Radian0523/control-air-with-phone/README.md

# home-ir-remote（おうちリモコン）

iPhone から三菱電機エアコンと天井照明を操作する個人プロジェクト。
iPhone → Cloudflare Worker / Durable Object → WebSocket (TLS) → ESP32 → 赤外線 → エアコン。

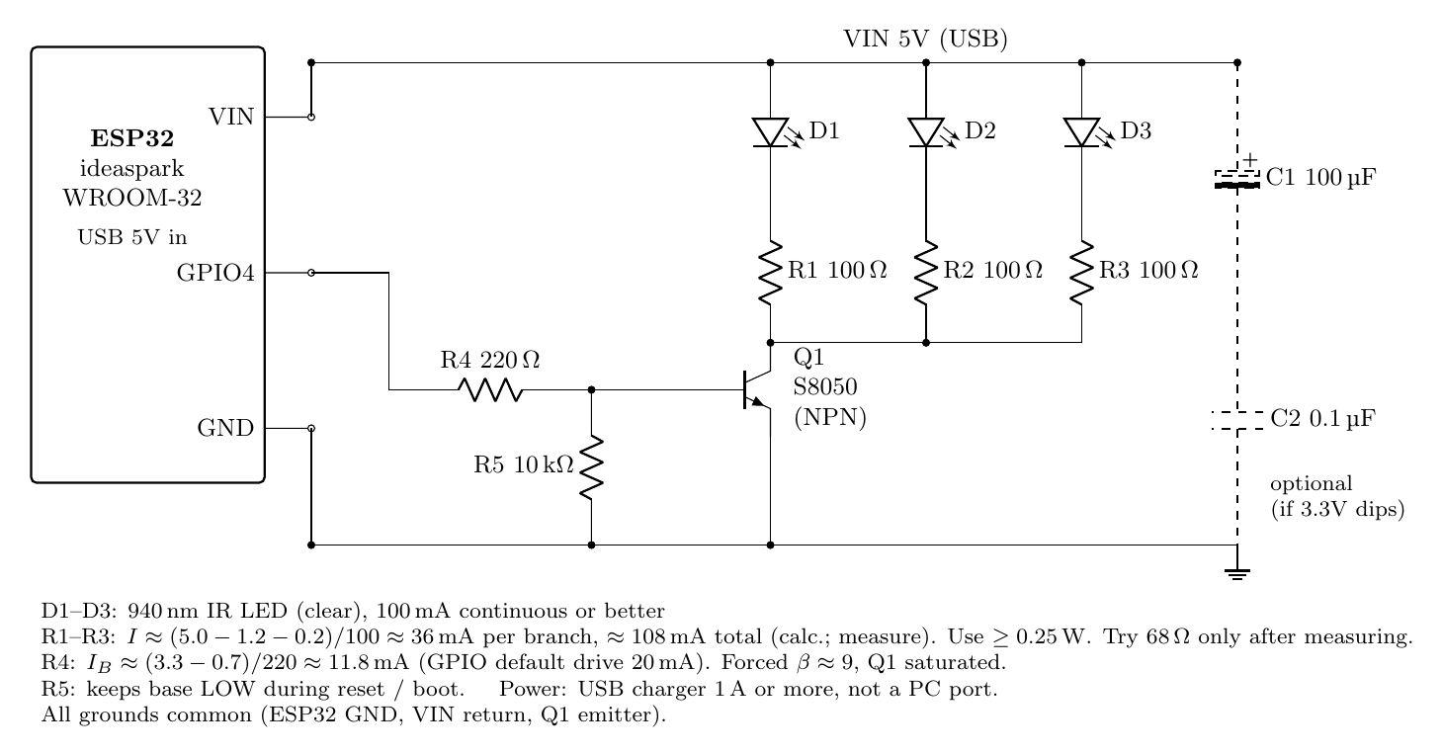
[picture p1: docs/circuit/ir_driver.png]
IR driver circuit


## 何ができるか

- iPhone アプリから電源・モード・温度・風量・風向を設定して即時送信
- 「この時刻にこの設定で」の一発予約 1 件（Durable Object の Alarm で発火）
- 照明（オーデリック）を全灯・ECO・常夜灯・消灯の 4 ボタンで操作（ADR-022）
- ESP32 は常時 WebSocket 接続。切断後は 30 秒周期で再接続し、10 分戻れなければ自動で再起動（ADR-021）
- 外出先からも同じ操作（LAN 直通経路は作らず、クラウド経由のみ。ADR-002）

## 構成

```
 iPhone (SwiftUI)
    │  HTTPS + Bearer(APP_TOKEN)
    ▼
 Cloudflare Worker ── 認証・API (/command, /light, /schedule)
    │  RPC
    ▼
 Durable Object "home" ── エアコンの 18 バイト / 照明の NEC コードを生成、予約 1 件を保持、Alarm
    │  WebSocket over TLS (Hibernation)、Bearer(DEVICE_TOKEN)
    ▼
 ESP32-WROOM-32 ── 36 文字（エアコン）/ 8 文字（照明）の HEX を受けて IRremoteESP8266 で送信するだけ
    │  GPIO4 → S8050 → IR LED ×3 (940nm)
    ▼
 三菱電機 エアコン (MITSUBISHI_AC, 144 bit) / オーデリック 照明 (NEC, 32 bit)
```

設計の要点は「ESP32 を最小にし、判断はすべてクラウドに置く」（ADR-001, 008）。
機器プロトコルは片方向で、Durable Object → ESP32 に 36 文字（エアコン）か 8 文字（照明）の大文字 HEX を 1 フレーム送るだけ（ADR-010, 022）。ESP32 は返答せず、不正入力は黙って捨てる。

## 技術スタック

| 層 | 主な技術 |
|---|---|
| iOS | SwiftUI, Keychain（トークン保管）, XCTest, xcodegen |
| クラウド | Cloudflare Workers, Durable Objects (SQLite, WebSocket Hibernation, Alarm), TypeScript, wrangler, vitest + `@cloudflare/vitest-pool-workers` |
| ファーム | arduino-esp32 3.3.11, IRremoteESP8266, arduinoWebSockets, Mozilla CA bundle (`gen_crt_bundle.py`) |
| ハード | ESP32-WROOM-32, S8050 + 100Ω ×3 で IR LED 駆動（約 36 mA/個）, 回路図は CircuiTikZ |
| ドキュメント | 設計書, ADR ×22, レビュー記録, 試験記録, 振り返り |

テスト: Cloudflare 57 件（純粋関数 + workerd 上の統合）, iOS 15 件, ファームは host 側で `ir_frame.h` の単体テスト。

## リポジトリ構成

| 場所 | 内容 |
|---|---|
| [`cloudflare/`](cloudflare/) | Worker と Durable Object。`encoder.ts` が三菱フレーム生成の中心 |
| [`firmware/aircon_bridge/`](firmware/aircon_bridge/) | 本番ファーム（状態機械、TLS、Task WDT） |
| [`firmware/ir_serial_test/`](firmware/ir_serial_test/) | Wi-Fi なしでシリアルから赤外線を出す試験スケッチ |
| [`ios/AirconRemote/`](ios/AirconRemote/) | SwiftUI アプリ（設定・操作・予約） |
| [`tools/`](tools/) | 赤外線の採取・解析、照明の送信試験、回路電圧の測定、Wi-Fi スキャン用スケッチ |
| [`docs/`](docs/) | 下記 |

## ドキュメント

| 文書 | 内容 |
|---|---|
| [docs/design.md](docs/design.md) | 現行仕様（API、機器プロトコル、フレーム規則、ログ、障害判断表） |
| [docs/adr.md](docs/adr.md) | 設計判断 ADR-001〜022。なぜその構成にしたか |
| [docs/review-2026-09-13.md](docs/review-2026-09-13.md) | 実装前の設計レビュー 2 往復（17 件） |
| [docs/implementation-plan.md](docs/implementation-plan.md) | 8 段階の実装計画と通過条件、進行表 |
| [docs/ir-captures.md](docs/ir-captures.md) | 実機リモコンの赤外線採取と規則の導出 |
| [docs/test-log.md](docs/test-log.md) | 各段階の試験記録とつまずき一覧 |
| [docs/dev-retrospective.md](docs/dev-retrospective.md) | 開発の振り返り。つまずき・原因・解決 |
| [docs/stage5-procedure.md](docs/stage5-procedure.md) | 障害系試験の手順（診断用） |
| [docs/circuit/](docs/circuit/) | 赤外線送信回路図（`.tex` / `.pdf` / `.png`） |

## 自分で動かす

各ディレクトリの README を参照。おおまかには

1. `cloudflare/`: `npm install` → `npx wrangler secret put DEVICE_TOKEN` / `APP_TOKEN` → `npm run deploy`
2. `firmware/aircon_bridge/`: `secrets.example.h` を `secrets.h` にコピーして SSID・パスワード・ホスト・トークンを記入（2.4GHz のみ）→ Arduino IDE で書き込み
3. `ios/AirconRemote/`: `xcodegen generate` → Xcode で実行 → 設定画面に Worker の URL と APP_TOKEN を入力

`secrets.h` と Worker のシークレットはご自身の環境に合わせてください。
