Radian0523/control-air-with-phone/docs/ir-captures.md

# 実機リモコン採取記録

対象: 三菱電機エアコン（`MITSUBISHI_AC`、144 bit / 18 byte）  
採取手段: `tools/ir_dump`（受信モジュール Y → GPIO15、R → 3.3V、G → GND。解析時だけ接続）  
照合手段: `cd cloudflare && node scripts/decode.ts <36文字> [--expect power,mode,temp,fan,vane]`

段階2a のゲート（実装計画）:

- 静音の fan値が規則の5と一致する → リモコンに静音が存在しないため列挙から削除（ADR-019）
- 暖房 20℃ / 風量4 / 風向low が §7.2 の4件目と一致する → 風量4も存在しない。暖房・風向lowest の採取値でベクトルを差し替え
- 電源ONとOFFを含む複数設定で byte 10〜16 が `00 00 00 00 00 10 00` に固定できる → byte 10〜14 と 16 は常に `00`。byte 15 は `10` / `00` の両方が現れ、`10` 固定を維持

## 採取表（2026-09-13 第1回）

受信環境: 受信モジュール → GPIO15、`tools/ir_dump`（許容誤差 35%、ノイズ閾値 50 bit）。UNKNOWN が混ざるが、成功フレームが十分に取れた。
リモコンの風量ボタンの巡回は 1 → 2 → 3 → 自動 の4段で、風量4と静音は確認されなかった。

byte 0〜4 は全採取で `23 CB 26 01 00`、byte 10〜14 と byte 16 は全採取で `00`。以下は byte 5〜9、15、17 だけを記す。

| 操作 | byte 5 power | 6 mode | 7 temp | 8 | 9 | 15 | 17 sum | decode 結果 | encoder と一致 |
|---|---|---|---|---|---|---|---|---|---|
| 電源OFF（電源ボタン） | 00 | 18 | 0A | 36 | 58 | **10** | D5 | OFF cool 26 fan0 vane3 | 一致 |
| 電源ON（電源ボタン） | 20 | 18 | 0A | 36 | 58 | **10** | F5 | ON cool 26 fan0 vane3 | 一致 |
| 温度など別ボタン後 | 20 | 18 | 0A | 36 | 58 | **00** | E5 | ON cool 26 fan0 vane3 | byte 15 のみ不一致 |
| 温度 25℃ | 20 | 18 | 09 | 36 | 58 | 00 | E4 | temp 25 | byte 15 のみ不一致 |
| 風量ボタン 1回目 | 20 | 18 | 0A | 36 | 59 | 00 | E6 | fan 1 | byte 15 のみ不一致 |
| 風量ボタン 2回目 | 20 | 18 | 0A | 36 | 5A | 00 | E7 | fan 2 | byte 15 のみ不一致 |
| 風量ボタン 3回目 | 20 | 18 | 0A | 36 | 5B | 00 | E8 | fan 3 | byte 15 のみ不一致 |
| 風量ボタン 4回目（自動） | 20 | 18 | 0A | 36 | **98** | 00 | 25 | fan 0、bit7=1、bit6=0 | **byte 9 不一致** |
| 風向 low | 20 | 18 | 0A | 36 | 61 | 00 | EE | fan1 vane4 | byte 15 のみ不一致 |
| 風向 lowest | 20 | 18 | 0A | 36 | 69 | 00 | F6 | fan1 vane5 | byte 15 のみ不一致 |
| 風向 swing | 20 | 18 | 0A | 36 | 79 | 00 | 06 | fan1 vane7 | byte 15 のみ不一致 |
| 風向 auto | 20 | 18 | 0A | 36 | **81** | 00 | 0E | fan1 vane0、bit7=1、bit6=0 | **byte 9 不一致** |
| 風向 highest | 20 | 18 | 0A | 36 | 49 | 00 | D6 | fan1 vane1 | byte 15 のみ不一致 |
| 風向 high | 20 | 18 | 0A | 36 | 51 | 00 | DE | fan1 vane2 | byte 15 のみ不一致 |
| 風向 middle | 20 | 18 | 0A | 36 | 59 | 00 | E6 | fan1 vane3 | byte 15 のみ不一致 |
| モード dry（24℃） | 20 | 10 | 08 | 32 | 69 | 00 | E8 | dry | byte 15 のみ不一致 |
| モード heat（26℃） | 20 | 08 | 0A | 30 | 69 | 00 | E0 | heat | byte 15 のみ不一致 |
| 電源ボタン（再度） | 20 | 18 | 0A | 36 | 69 | **10** | 06 | ON cool 26 fan1 vane5 | 一致 |

### 規則との照合結果

一致が確認できた規則:

- byte 5 power、byte 6 と 8 の mode（cool 18/36、dry 10/32、heat 08/30）、byte 7 = temp − 16
- byte 9 の vane値 1〜5 と 7、fan値 1〜3。bit 6 = 1、bit 7 = 0 の形（規則どおり）
- byte 10〜14、byte 16 は常に 00
- byte 17 のチェックサム

規則と異なる観察:

1. **byte 15 は電源ボタンのフレームだけ `10`、他のボタンでは `00`**。byte 5 の power とは独立で、OFF フレームでも `10` だった。規則の固定値 `10` は電源ボタン相当の値であり、AC は両方を受理している。→ 規則は変更しない。段階2c で `10` 固定の非電源操作（温度変更など）に AC が反応することを確認する。
2. **byte 9 の上位2bit**。風量ボタンで「自動」を選んだフレームは `98`（bit7=1、bit6=0）、風向ボタンで「自動」を選んだフレームは `81`（bit7=1、bit6=0）。一方、電源ボタンのフレームでは fan auto が `58`（bit7=0、bit6=1）で表現されていた。規則（常に `40 | vane<<3 | fan`）は電源ボタン形式にだけ一致する。vane auto を規則で生成すると `41` になるが、この形は採取されていない。→ 追加採取で「フル状態」フレームでの表現を確定する（下記）。
3. **風量4と静音はこのリモコンにない**（巡回は 1→2→3→自動）。→ 設計§5.4 の fan 列挙から `quiet` と `4` を外す候補。

## 採取表（2026-09-16 第2回: 追加採取）

| 操作 | byte 5 | 6 | 7 | 8 | 9 | 15 | 17 | decode 結果 | encoder と一致 |
|---|---|---|---|---|---|---|---|---|---|
| 風向 auto にしてから電源ON | 20 | 18 | 0A | 36 | **41** | 10 | DE | ON cool 26 fan1 vane0 | **完全一致** |
| 風量 auto にしてから電源操作 | 20 | 18 | 0A | 36 | **40** | 00 | CD | ON cool 26 fan0 vane0 | byte 15 のみ不一致 |
| リセットボタン後に電源ON | 20 | 18 | 05 | 36 | **40** | 00 | C8 | ON cool 26→21℃ fan0 vane0 | byte 15 のみ不一致 |

リモコンの仕様（所有者確認）: 風量は 1 / 2 / 3 / 自動。モードに自動と送風はない。時刻設定はない。静音はなく、「パワフル」ボタンがある。

### 結論（2026-09-16）

- **byte 9 の規則 `40 | vane<<3 | fan`（bit 6=1、bit 7=0）はフルステートフレームで確定**。風向自動は `41`、風量・風向とも自動は `40`。第1回で見えた `98` / `81` はボタン操作直後だけの一時的な表現で、encoder は採用しない
- **byte 15 は `10` 固定を維持**。電源ボタンでは `10`、他のボタンやリセット後は `00` になるが、エアコンは両方を受理する
- **風量の `quiet` と `4` を列挙から外す**（ADR-019）。mode の `auto` と `fan` は採取できないため IRremoteESP8266 の値を保持する
- design.md §7.2 のテストベクトルを採取値ベースの5件へ差し替えた
- 段階2a のゲートは通過。パワフルは現在の要件外とし、必要になれば採取して追加する

### 第1回時点で追加採取が必要だった項目（第2回で解消）

電源ボタンのフレームは、リモコンが保持する全状態を載せるので、encoder が作るべき「フル状態」の正解になる。

- 風向ボタンで「自動」にした後、電源 OFF → ON を押し、両フレームの byte 9 を見る（vane auto のフル状態表現）
- 風量ボタンで「自動」にした後、電源 OFF → ON を押し、両フレームの byte 9 を見る（fan auto のフル状態表現が `58` 系か `98` 系か）
- モード「自動」と「送風」があれば、それぞれ選んだ後に電源 OFF → ON（byte 6 / 8 の auto=20/30、fan=38/37 の確認）
- リモコンの風量表示の段数（自動を除いて3段か）と、「静音」「パワフル」などの別ボタンの有無

## byte 10〜16 の観察

採取した全レコードの byte 10〜16 を並べる。ゼロでない値があれば、時計・タイマー由来かをリモコンの時刻設定を変えて再採取して切り分ける。

| 採取 | byte 10 | 11 | 12 | 13 | 14 | 15 | 16 |
|---|---|---|---|---|---|---|---|
| 既存（dry 24℃） | 00 | 00 | 00 | 00 | 00 | 10 | 00 |
| 第1回 電源ボタン（3件） | 00 | 00 | 00 | 00 | 00 | 10 | 00 |
| 第1回 その他ボタン（15件） | 00 | 00 | 00 | 00 | 00 | 00 | 00 |

時計・タイマー由来の値は出ていない。このリモコンには時刻設定がないため、byte 10〜14 は常に `00` と確定する。

## 結論

（採取後に記入。規則を変更した場合は design.md §7.1、encoder.ts、ADR-008 の結果へ追記し、ここにリンクを残す）

## 照明リモコン採取（2026-11-03）

対象: オーデリック リモコン送信機 NRL-3321。チャンネル設定は採取時のまま変更していない。
採取: `tools/ir_dump`（受信モジュール Y → GPIO15）、各ボタンを1回ずつ短押し。

| ボタン | プロトコル | ビット数 | コード | アドレス（16bit） | コマンド / 反転 |
|---|---|---|---|---|---|
| ECO | NEC | 32 | `0x01A3748B` | `0x01A3` | `0x74` / `0x8B` |
| ON | NEC | 32 | `0x01A359A6` | `0x01A3` | `0x59` / `0xA6` |
| 豆電 | NEC | 32 | `0x01A354AB` | `0x01A3` | `0x54` / `0xAB` |
| OFF | NEC | 32 | `0x01A310EF` | `0x01A3` | `0x10` / `0xEF` |

- 4件とも同じアドレス `0x01A3`（拡張 NEC。2バイト目は1バイト目の反転ではない）で、コマンドは反転バイトと XOR して `0xFF` になる
- エアコンのような状態フレームではなく、ボタンごとの固定コード
- 送信試験（2026-11-03）: `tools/ir_light_send_test` から本番と同じ GPIO4 の LED 回路で `IRsend::sendNEC(code, 32)` を1回ずつ送り、OFF → ON → 豆電 → ECO → ON の5回すべてに照明が反応した。再送や繰り返しは不要
