Radian0523/control-air-with-phone/docs/circuit/ir_driver.pdf

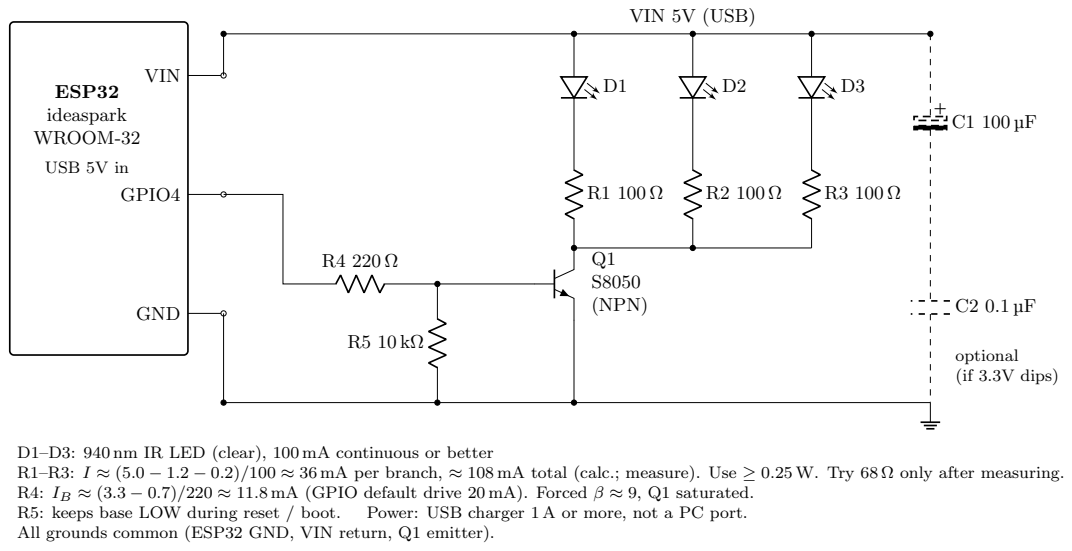
[picture p2: page 1]

D1–D3: 940 nm IR LED (clear), 100 mA continuous or better
R1–R3: I ≈ (5.0 − 1.2 − 0.2)/100 ≈ 36 mA per branch, ≈ 108 mA total (calc.; measure). Use ≥ 0.25W. Try 68 Ω only after measuring.
R4: IB ≈ (3.3 − 0.7)/220 ≈ 11.8 mA (GPIO default drive 20 mA). Forced β ≈ 9, Q1 saturated.
All grounds common (ESP32 GND, VIN return, Q1 emitter).
