Radian0523/control-air-with-phone/firmware/aircon_bridge/ca_bundle.h

const unsigned char ca_bundle[] = {
  0x00, 0x79, 0x00, 0x3a, 0x02, 0x26, 0x30, 0x38, 0x31, 0x0b, 0x30, 0x09,
  0x06, 0x03, 0x55, 0x04, 0x06, 0x13, 0x02, 0x45, 0x53, 0x31, 0x14, 0x30,
  0x12, 0x06, 0x03, 0x55, 0x04, 0x0a, 0x0c, 0x0b, 0x49, 0x5a, 0x45, 0x4e,
  0x50, 0x45, 0x20, 0x53, 0x2e, 0x41, 0x2e, 0x31, 0x13, 0x30, 0x11, 0x06,
  0x03, 0x55, 0x04, 0x03, 0x0c, 0x0a, 0x49, 0x7a, 0x65, 0x6e, 0x70, 0x65,
  0x2e, 0x63, 0x6f, 0x6d, 0x30, 0x82, 0x02, 0x22, 0x30, 0x0d, 0x06, 0x09,
  0x2a, 0x86, 0x48, 0x86, 0xf7, 0x0d, 0x01, 0x01, 0x01, 0x05, 0x00, 0x03,
  0x82, 0x02, 0x0f, 0x00, 0x30, 0x82, 0x02, 0x0a, 0x02, 0x82, 0x02, 0x01,
  0x00, 0xc9, 0xd3, 0x7a, 0xca, 0x0f, 0x1e, 0xac, 0xa7, 0x86, 0xe8, 0x16,
  0x65, 0x6a, 0xb1, 0xc2, 0x1b, 0x45, 0x32, 0x71, 0x95, 0xd9, 0xfe, 0x10,
  0x5b, 0xcc, 0xaf, 0xe7, 0xa5, 0x79, 0x01, 0x8f, 0x89, 0xc3, 0xca, 0xf2,
  0x55, 0x71, 0xf7, 0x77, 0xbe, 0x77, 0x94, 0xf3, 0x72, 0xa4, 0x2c, 0x44,
  0xd8, 0x9e, 0x92, 0x9b, 0x14, 0x3a, 0xa1, 0xe7, 0x24, 0x90, 0x0a, 0x0a,
  0x56, 0x8e, 0xc5, 0xd8, 0x26, 0x94, 0xe1, 0xd9, 0x48, 0xe1, 0x2d, 0x3e,
  0xda, 0x0a, 0x72, 0xdd, 0xa3, 0x99, 0x15, 0xda, 0x81, 0xa2, 0x87, 0xf4,
  0x7b, 0x6e, 0x26, 0x77, 0x89, 0x58, 0xad, 0xd6, 0xeb, 0x0c, 0xb2, 0x41,
  0x7a, 0x73, 0x6e, 0x6d, 0xdb, 0x7a, 0x78, 0x41, 0xe9, 0x08, 0x88, 0x12,
  0x7e, 0x87, 0x2e, 0x66, 0x11, 0x63, 0x6c, 0x54, 0xfb, 0x3c, 0x9d, 0x72,
  0xc0, 0xbc, 0x2e, 0xff, 0xc2, 0xb7, 0xdd, 0x0d, 0x76, 0xe3, 0x3a, 0xd7,
  0xf7, 0xb4, 0x68, 0xbe, 0xa2, 0xf5, 0xe3, 0x81, 0x6e, 0xc1, 0x46, 0x6f,
  0x5d, 0x8d, 0xe0, 0x4d, 0xc6, 0x54, 0x55, 0x89, 0x1a, 0x33, 0x31, 0x0a,
  0xb1, 0x57, 0xb9, 0xa3, 0x8a, 0x98, 0xc3, 0xec, 0x3b, 0x34, 0xc5, 0x95,
  0x41, 0x69, 0x7e, 0x75, 0xc2, 0x3c, 0x20, 0xc5, 0x61, 0xba, 0x51, 0x47,
  0xa0, 0x20, 0x90, 0x93, 0xa1, 0x90, 0x4b, 0xf3, 0x4e, 0x7c, 0x85, 0x45,
  0x54, 0x9a, 0xd1, 0x05, 0x26, 0x41, 0xb0, 0xb5, 0x4d, 0x1d, 0x33, 0xbe,
  0xc4, 0x03, 0xc8, 0x25, 0x7c, 0xc1, 0x70, 0xdb, 0x3b, 0xf4, 0x09, 0x2d,
  0x54, 0x27, 0x48, 0xac, 0x2f, 0xe1, 0xc4, 0xac, 0x3e, 0xc8, 0xcb, 0x92,
  0x4c, 0x53, 0x39, 0x37, 0x23, 0xec, 0xd3, 0x01, 0xf9, 0xe0, 0x09, 0x44,
  0x4d, 0x4d, 0x64, 0xc0, 0xe1, 0x0d, 0x5a, 0x87, 0x22, 0xbc, 0xad, 0x1b,
  0xa3, 0xfe, 0x26, 0xb5, 0x15, 0xf3, 0xa7, 0xfc, 0x84, 0x19, 0xe9, 0xec,
  0xa1, 0x88, 0xb4, 0x44, 0x69, 0x84, 0x83, 0xf3, 0x89, 0xd1, 0x74, 0x06,
  0xa9, 0xcc, 0x0b, 0xd6, 0xc2, 0xde, 0x27, 0x85, 0x50, 0x26, 0xca, 0x17,
  0xb8, 0xc9, 0x7a, 0x87, 0x56, 0x2c, 0x1a, 0x01, 0x1e, 0x6c, 0xbe, 0x13,
  0xad, 0x10, 0xac, 0xb5, 0x24, 0xf5, 0x38, 0x91, 0xa1, 0xd6, 0x4b, 0xda,
  0xf1, 0xbb, 0xd2, 0xde, 0x47, 0xb5, 0xf1, 0xbc, 0x81, 0xf6, 0x59, 0x6b,
  0xcf, 0x19, 0x53, 0xe9, 0x8d, 0x15, 0xcb, 0x4a, 0xcb, 0xa9, 0x6f, 0x44,
  0xe5, 0x1b, 0x41, 0xcf, 0xe1, 0x86, 0xa7, 0xca, 0xd0, 0x6a, 0x9f, 0xbc,
  0x4c, 0x8d, 0x06, 0x33, 0x5a, 0xa2, 0x85, 0xe5, 0x90, 0x35, 0xa0, 0x62,
  0x5c, 0x16, 0x4e, 0xf0, 0xe3, 0xa2, 0xfa, 0x03, 0x1a, 0xb4, 0x2c, 0x71,
  0xb3, 0x58, 0x2c, 0xde, 0x7b, 0x0b, 0xdb, 0x1a, 0x0f, 0xeb, 0xde, 0x21,
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
};
const unsigned int ca_bundle_len = 55587;
