Radian0523/control-air-with-phone/(commit log)

2026-09-13 chore: リポジトリ準備（段階0）
    - 設計・ADR・レビュー・実装計画・回路図
    - 赤外線解析スケッチ（tools/）
    - cloudflare/ firmware/ ios/ の骨格と README
    - secrets.example.h と CA bundle 記録の雛形
    - wrangler / vitest / vitest-pool-workers を devDependency に固定
2026-09-13 feat(cloudflare): Encoder と検証の純粋関数（段階1）
    - encoder.ts: design.md §7.1 の18バイト生成と36文字化
    - validate.ts: §5.4 設定検証、§5.2 executeAt 検証（現在時刻は引数）
    - test: §7.2 の4ベクトル（採取/導出を明記）、形式の不変条件、境界値
    - tsconfig / vitest.config（段階1は Node 環境）
2026-09-13 feat(firmware): シリアル試験スケッチと採取準備（段階2c）
    - firmware/ir_serial_test: USBシリアルから36文字を受けて MITSUBISHI_AC 送信
    - ir_frame.h: §4.3 の検証と18バイト変換。本番ファームと共用する
    - host_test: 不正入力の拒否をホスト側で検査
    - docs/ir-captures.md: 段階2a の採取記録テンプレート
    - cloudflare/scripts/decode.ts: 採取36文字の分解と encoder との照合
2026-09-13 fix(tools): ir_dump が UNKNOWN 時に生タイミングを出力し、許容誤差とノイズ閾値を調整
    [ir_dump.ino]
2026-09-13 docs: 実機リモコン採取 第1回の記録と規則との照合結果
2026-09-16 feat(cloudflare): 採取結果を設計・ADR・encoder へ反映（段階2a 完了）
    - byte 9 の規則をフルステートフレームで確定、byte 15 は 10 固定を維持
    - 風量の列挙を auto/1/2/3 へ変更（ADR-019: リモコンに存在する値だけ）
    - §7.2 テストベクトルを採取値ベースの5件へ差し替え
    - ir-captures.md に第2回採取と結論を記録
2026-09-17 fix(firmware): ir_serial_test の loop() で IDLE1 へ譲り Task WDT パニックを解消、出力ラッチ初期化を gpio_set_level へ
    - core 3.3.11 は CONFIG_ESP_TASK_WDT_PANIC=y / 5s。譲らない loop() が IDLE1 を飢餓させ再起動していた
    - core 3.x の digitalWrite() は pinMode() 前は無効。設計 §4.1 / §4.4 / §10 と ADR-006 を更新
    [ir_serial_test.ino]
2026-09-17 fix(firmware): ir_serial_test で core 1 の idle hook を登録して Task WDT を正しく動かす
    core 3.x の enableCore1WDT() は IDLE1 を監視対象に追加するだけで、
    IDF が本来登録する idle hook（esp_task_wdt_reset）を仕込まない。
    hook なしでは IDLE1 が走っても WDT を永久にリセットできず 5 秒で再起動する。
    設計 §4.1 / §4.4 と ADR-006 を3点セット（add / hook / delay）へ更新。
    [ir_serial_test.ino]
2026-09-17 docs(plan): 段階2 実機でエアコン反応を確認
2026-09-17 feat(tools): ir_probe を追加、ESP32 の ADC で回路電圧を測る計測スケッチ
2026-09-17 docs: 段階2 完了、試験記録を追加し進行表を更新
2026-09-17 feat: Worker/DO 骨格、CA bundle、本番ファーム（段階3）
    - cloudflare: /device/ws の Bearer 認証と DO "home" への転送、Hibernation で device socket を1本保持・置換
    - auth.ts: SHA-256 + timingSafeEqual、log.ts: JSON 1行ログ
    - vitest を unit / workers の2プロジェクトに分割（pool-workers 0.22 の cloudflareTest プラグイン）
    - firmware/ca_bundle: Mozilla bundle 2026-08-13 版、121 証明書、55,587B
    - firmware/aircon_bridge: 状態機械（CONNECTING/ONLINE/TEARDOWN/OFF_WAIT）、Task WDT 3点セット、1サイクル1試行
2026-09-17 chore(cloudflare): Worker を初回デプロイ、接続先ホストを雛形に反映（段階3）
2026-09-17 feat(firmware): wifi_failed に status コードを付与、tools/wifi_scan を追加
2026-09-17 feat(cloudflare): POST /command を実装・デプロイ（段階4）
    - Worker: APP_TOKEN 照合 → validateSetting → DO の command() を RPC で呼ぶ
    - DO: encode → device socket へ1回 send。なし/例外は 503 device_offline
    - 統合テスト: 401/400/405/202（36文字が届く）/503
2026-09-17 docs: 段階3・4 完了、通し試験の記録
2026-09-17 feat(firmware): 試験用ビルド切替（heap / tls_ms）と ws_failed ログ、障害系試験手順書（段階5 準備）
2026-09-17 feat(ios): 設定・操作画面（SwiftUI、xcodegen）（段階6）
    - Keychain に APP_TOKEN、UserDefaults に URL と設定値の正本
    - POST /command と §6 のエラー文言対応、202 は「受け付けました」表示
    - Setting の JSON 形式と列挙値を固定するユニットテスト 8件
2026-09-17 docs(adr): ADR-020 段階5 の障害系試験を省略し通常運用で置き換える
2026-09-17 feat: 一発予約（schedule API、Alarm、iOS 予約画面）（段階7）
    - DO: 予約1件を storage に保存し setAlarm。alarm() は読む→削除→1回 send の順序で二重送信を防ぐ
    - Worker: GET/PUT/DELETE /schedule。executeAt は UTC 正規形と未来だけ受理
    - 統合テスト: 置換、取消、offline 破棄、再発火で二重送信なし、不正 executeAt で予約不変
    - iOS: ScheduleView（GET/PUT/DELETE）、ExecuteAtFormat（UTC・小数秒なし）とテスト
2026-09-17 docs: 段階6・7 完了、実機操作と予約発火、電源断からの自動復帰を記録
2026-09-17 docs: 段階8 完了、設置と通し確認。全段階完了
2026-09-18 docs: 開発の振り返り（流れ・つまずき・原因・解決）
2026-09-18 docs: test-log のコミット参照を書き換え後のハッシュへ更新
2026-09-18 docs: README を公開向けに拡充、MIT ライセンスを追加
2026-09-18 docs(ios): AirconRemote の README を追加
2026-09-18 docs: READMEから学びを消し小さくする
2026-09-18 feat(ios): 予約を操作画面に統合し、別画面は設定だけにする
    - ScheduleView を ScheduleSection に変え、操作画面の Form 末尾に置く
    - 送信ボタンを「今すぐ送る」に改名し、結果表示を同じセクションへ
    - 電源 OFF のとき運転セクションを無効表示にする
    - 未設定時は先頭に設定画面へのボタンを出す
    - 予約時刻の初期値を次の00分（最短10分後）にする
    - design.md §6 と iOS README の画面構成の記述を更新
2026-09-24 ui: わかりやすく、単純に。
2026-09-24 chore(ios): swift-format の設定を追加し既存コードへ適用
    VS Code の保存時整形と手書きのスタイルを揃える。
    4スペース、行長140、既存の改行を尊重。
2026-09-24 ux: デフォルト予約時間を5分後に
2026-11-03 fix(firmware): 自力で戻れない時だけ再起動し、診断記録を NVS に残す
    USB アダプタ運用では起動から約1.7時間で切断され、その後は電源を
    入れ直すまで Cloudflare へ接続試行が届かなかった。Mac 給電では同じ
    切断から35秒で復帰したため、運用環境でだけ起きる停止を自動で救う。
    - ONLINE を離れて10分戻れなければ ESP.restart()
    - loop() が5分回らなければ esp_timer から再起動（Task WDT は変えない）
    - 起動・切断・自動再起動の直近16件を NVS に残し、起動時に diag 行で出す
    - 切断理由、Wi-Fi 切断理由、リセット理由をシリアルロ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
2026-11-03 feat: 天井照明（オーデリック）を全灯・ECO・常夜灯・消灯の4ボタンで操作する
    リモコン NRL-3321 の4ボタンを採取すると、すべて NEC 32bit・アドレス
    0x01A3 の固定コードだった。既存の LED 回路から sendNEC で送り、4ボタン
    とも反応することを確認した上で、同じ WebSocket 接続に載せる（ADR-022）。
    - ESP32: 36文字はエアコン、8文字は照明（NEC）として長さで区別する
    - Cloudflare: POST /light を追加。ボタンとコードの対応は light.ts だけが持つ
    - iOS: 操作画面の先頭に照明の4ボタンを置く
    - tools: ir_dump で短い信号も拾うようにし、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
2026-11-03 ui(ios): アプリ名を「おうちリモコン」にし、アイコンを付ける
    照明も操作できるようになり「エアコン」では合わなくなったため。
    アイコンの元絵は ios/AirconRemote/icon/AppIcon.svg。
2026-11-03 docs: リポジトリ名を home-ir-remote に変更
